carrefinho/caroline/ergogen/README.md

# Ergogen config

[`config.yaml`](config.yaml) places each key with its own hand-tuned dials under `units`: column splay, pitch and lift, plus per-key nudges and rotations. It outputs outlines (keycaps, plate cutouts, keywell, case cutout) that serve as references for the KiCad PCB file and the case.
