carrefinho/caroline/caroline-pcb/caroline-pcb.step

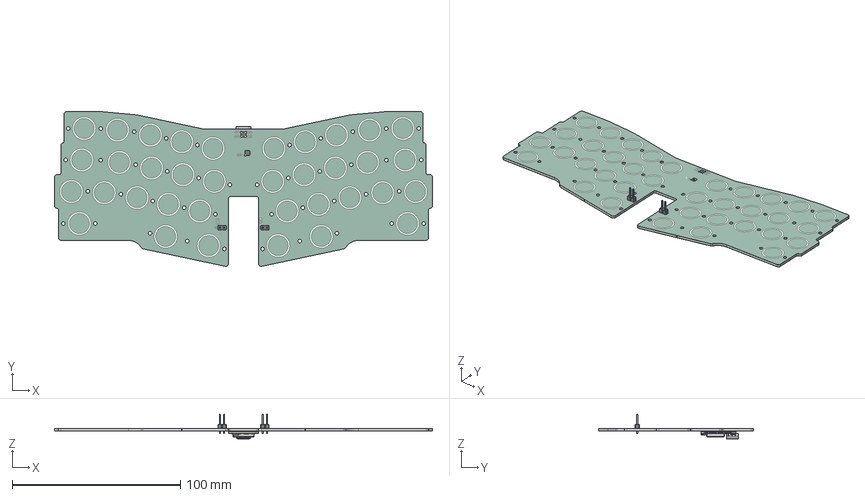
[picture p2: CAD file, 2026-11-11]
caroline-pcb/caroline-pcb.step
224.9 x 92.1 x 14.6 mm
PinHeader_1x02_P254mm_Vertical x 2
BOSS-EXTRUDE14_8_
BOSS-EXTRUDE7_4_
BOSS-EXTRUDE7_3_
BOSS-EXTRUDE14_4_
BOSS-EXTRUDE14_2_
BOSS-EXTRUDE14_11_
BOSS-EXTRUDE7_7_
BOSS-EXTRUDE14_9_
BOSS-EXTRUDE14_3_
BOSS-EXTRUDE14_7_
MIRROR2
BOSS-EXTRUDE14_5_
BOSS-EXTRUDE14_12_
BOSS-EXTRUDE7_8_
BOSS-EXTRUDE7_1_
BOSS-EXTRUDE14_10_
BOSS-EXTRUDE7_9_
BOSS-EXTRUDE14_6_
BOSS-EXTRUDE14_1_
BOSS-EXTRUDE7_6_
BOSS-EXTRUDE7_2_
CUT-EXTRUDE5
BOSS-EXTRUDE7_5_
Shield
Pins
CAP x 2
ANT1
Silkscreen
CAP 3
LED
USR
2 v1
055A-pcb_silkscreen x 2
055A-pcb_soldermask x 2
055A-pcb_PCB
