carrefinho/caroline/caroline-pcb/caroline-pcb.kicad_pcb

## KiCad design caroline-pcb/caroline-pcb.kicad_pcb (2026-11-12)

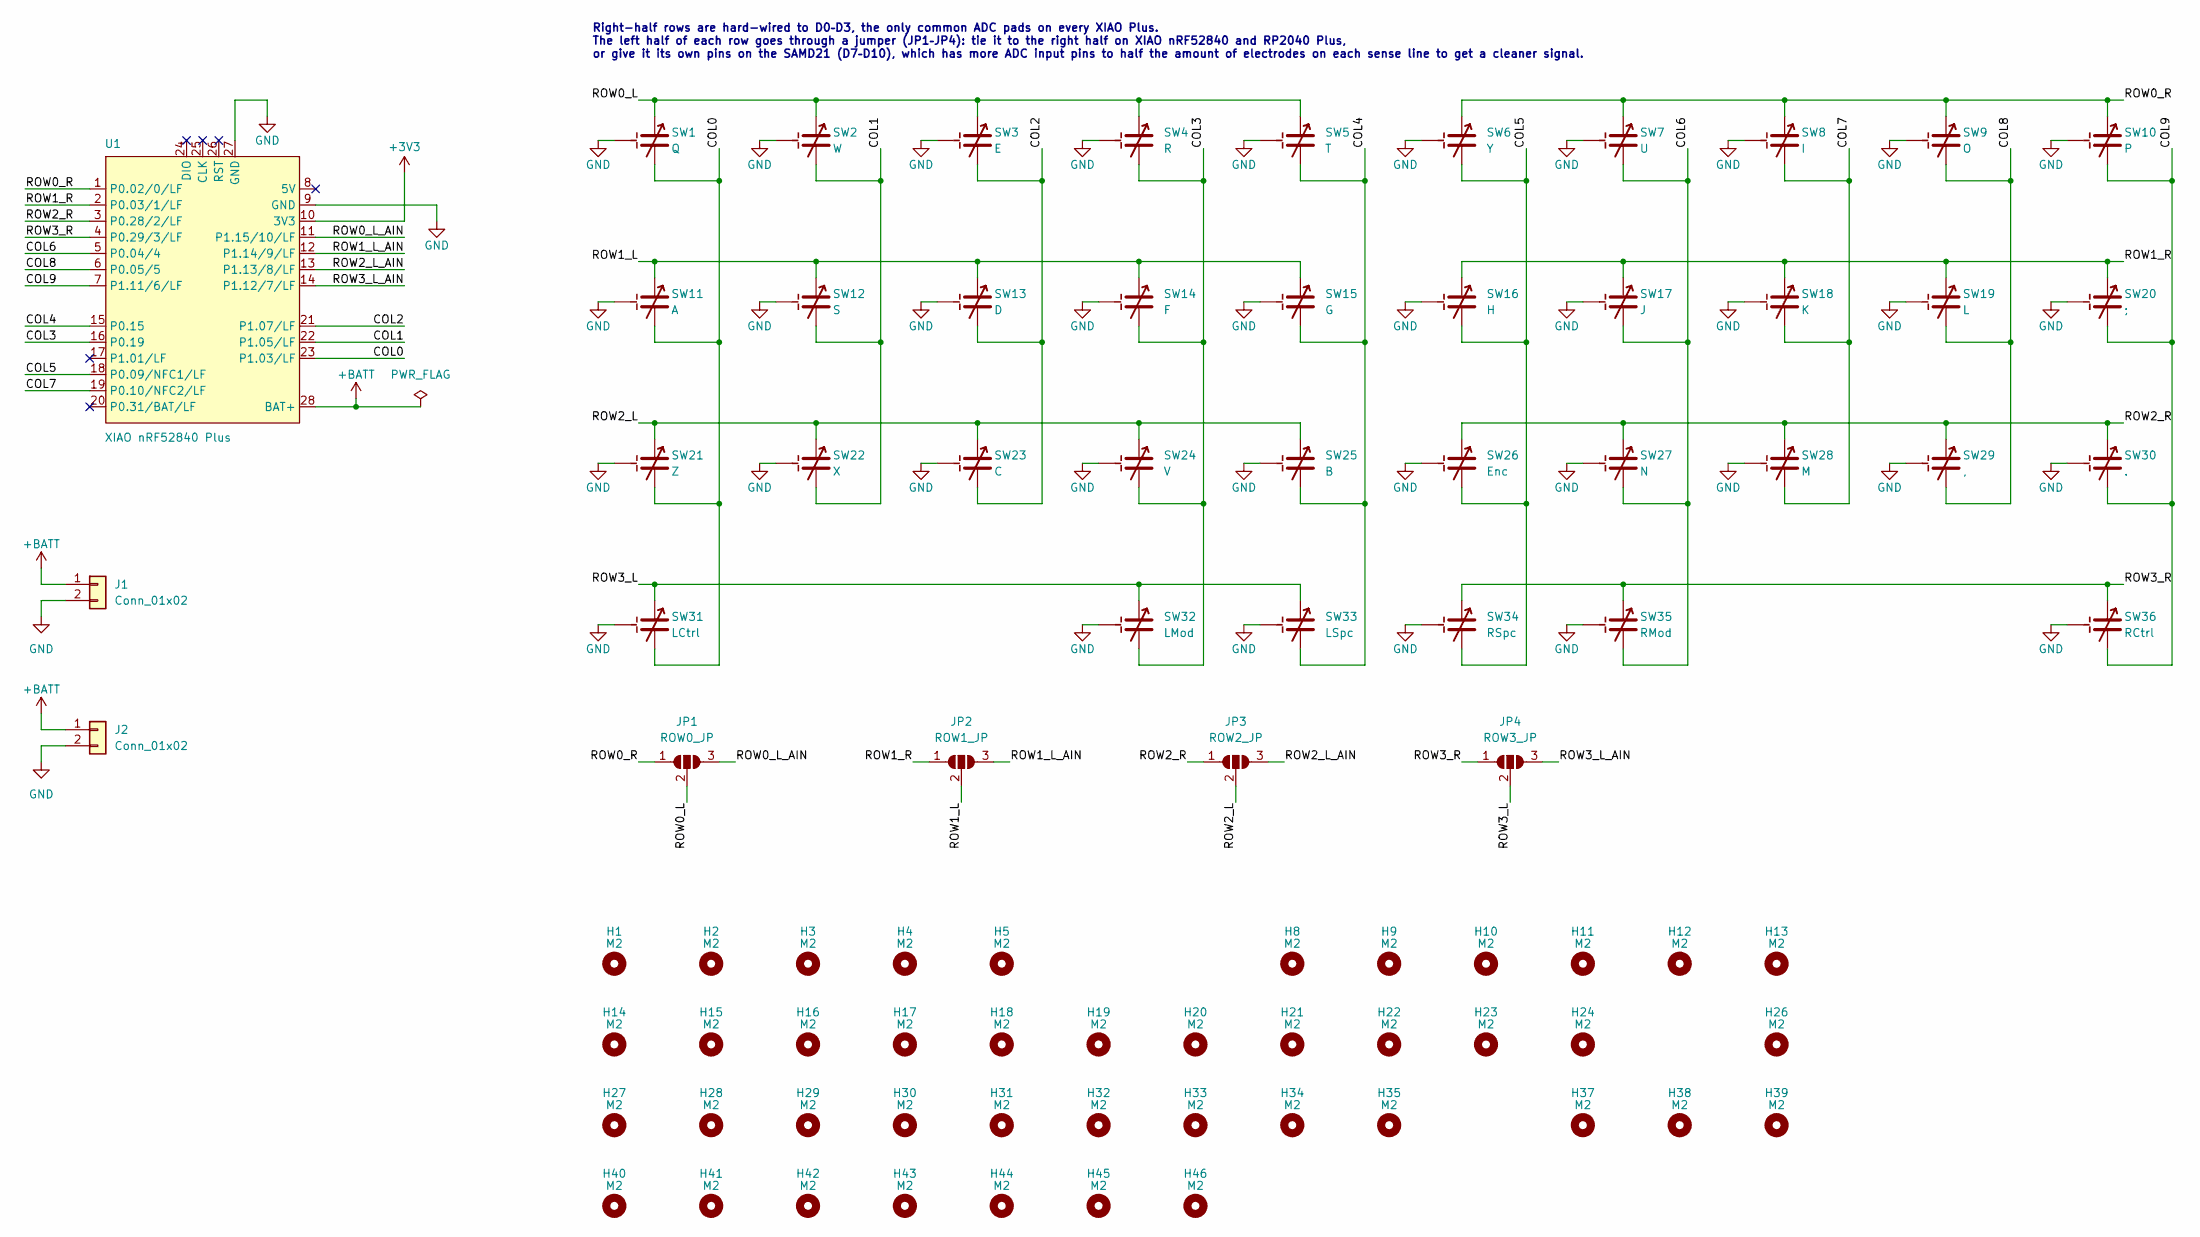
[picture p3: schematic caroline-pcb.kicad_sch]

Parts:
H1, H3, H5, H8, H10, H12, H15, H17, H20, H22, H26, H28, H33, H35, H37, H39, H41, H42, H44, H46: M2; MountingHole_2.2mm_M2_ring_silk
H2, H4, H9, H11, H13, H14, H16, H18, H19, H21, H23, H24, H27, H29, H30, H31, H32, H34, H38, H40, H43, H45: M2; MountingHole_2.2mm_M2
J1, J2: Conn_01x02; PinHeader_1x02_P2.54mm_Vertical
JP1: ROW0_JP; SolderJumper-3_P1.3mm_Open_RoundedPad1.0x1.5mm
JP2: ROW1_JP; SolderJumper-3_P1.3mm_Open_RoundedPad1.0x1.5mm
JP3: ROW2_JP; SolderJumper-3_P1.3mm_Open_RoundedPad1.0x1.5mm
JP4: ROW3_JP; SolderJumper-3_P1.3mm_Open_RoundedPad1.0x1.5mm
SW1: Q; EC_Topre_1U_ViaSP
SW2: W; EC_Topre_1U_ViaSP
SW3: E; EC_Topre_1U_ViaSP
SW4: R; EC_Topre_1U_ViaSP
SW5: T; EC_Topre_1U_ViaSP
SW6: Y; EC_Topre_1U_ViaSP
SW7: U; EC_Topre_1U_ViaSP
SW8: I; EC_Topre_1U_ViaSP
SW9: O; EC_Topre_1U_ViaSP
SW10: P; EC_Topre_1U_ViaSP
SW11: A; EC_Topre_1U_ViaSP
SW12: S; EC_Topre_1U_ViaSP
SW13: D; EC_Topre_1U_ViaSP
SW14: F; EC_Topre_1U_ViaSP
SW15: G; EC_Topre_1U_ViaSP
SW16: H; EC_Topre_1U_ViaSP
SW17: J; EC_Topre_1U_ViaSP
SW18: K; EC_Topre_1U_ViaSP
SW19: L; EC_Topre_1U_ViaSP
SW20: ;; EC_Topre_1U_ViaSP
SW21: Z; EC_Topre_1U_ViaSP
SW22: X; EC_Topre_1U_ViaSP
SW23: C; EC_Topre_1U_ViaSP
SW24: V; EC_Topre_1U_ViaSP
SW25: B; EC_Topre_1U_ViaSP
SW26: Enc; EC_Topre_1U_ViaSP
SW27: N; EC_Topre_1U_ViaSP
SW28: M; EC_Topre_1U_ViaSP
SW29: ,; EC_Topre_1U_ViaSP
SW30: .; EC_Topre_1U_ViaSP
SW31: LCtrl; EC_Topre_1U_ViaSP
SW32: LMod; EC_Topre_1U_ViaSP
SW33: LSpc; EC_Topre_1U_ViaSP
SW34: RSpc; EC_Topre_1U_ViaSP
SW35: RMod; EC_Topre_1U_ViaSP
SW36: RCtrl; EC_Topre_1U_ViaSP
U1: XIAO nRF52840 Plus; Xiao_nRF52840_Plus

Connections:
+3V3: U1.10 (3V3)
+BATT: J1.1, J2.1, U1.28 (BAT+)
/COL0: SW1.2, SW11.2, SW21.2, SW31.2, U1.23 (P1.03/LF)
/COL1: SW2.2, SW12.2, SW22.2, U1.22 (P1.05/LF)
/COL2: SW3.2, SW13.2, SW23.2, U1.21 (P1.07/LF)
/COL3: SW4.2, SW14.2, SW24.2, SW32.2, U1.16 (P0.19)
/COL4: SW5.2, SW15.2, SW25.2, SW33.2, U1.15 (P0.15)
/COL5: SW6.2, SW16.2, SW26.2, SW34.2, U1.18 (P0.09/NFC1/LF)
/COL6: SW7.2, SW17.2, SW27.2, SW35.2, U1.5 (P0.04/4)
/COL7: SW8.2, SW18.2, SW28.2, U1.19 (P0.10/NFC2/LF)
/COL8: SW9.2, SW19.2, SW29.2, U1.6 (P0.05/5)
/COL9: SW10.2, SW20.2, SW30.2, SW36.2, U1.7 (P1.11/6/LF)
/ROW0_L: JP1.2 (C), SW1.1 (S), SW2.1 (S), SW3.1 (S), SW4.1 (S), SW5.1 (S)
/ROW0_L_AIN: JP1.3 (B), U1.11 (P1.15/10/LF)
/ROW0_R: JP1.1 (A), SW6.1 (S), SW7.1 (S), SW8.1 (S), SW9.1 (S), SW10.1 (S), U1.1 (P0.02/0/LF)
/ROW1_L: JP2.2 (C), SW11.1 (S), SW12.1 (S), SW13.1 (S), SW14.1 (S), SW15.1 (S)
/ROW1_L_AIN: JP2.3 (B), U1.12 (P1.14/9/LF)
/ROW1_R: JP2.1 (A), SW16.1 (S), SW17.1 (S), SW18.1 (S), SW19.1 (S), SW20.1 (S), U1.2 (P0.03/1/LF)
/ROW2_L: JP3.2 (C), SW21.1 (S), SW22.1 (S), SW23.1 (S), SW24.1 (S), SW25.1 (S)
/ROW2_L_AIN: JP3.3 (B), U1.13 (P1.13/8/LF)
/ROW2_R: JP3.1 (A), SW26.1 (S), SW27.1 (S), SW28.1 (S), SW29.1 (S), SW30.1 (S), U1.3 (P0.28/2/LF)
/ROW3_L: JP4.2 (C), SW31.1 (S), SW32.1 (S), SW33.1 (S)
/ROW3_L_AIN: JP4.3 (B), U1.14 (P1.12/7/LF)
/ROW3_R: JP4.1 (A), SW34.1 (S), SW35.1 (S), SW36.1 (S), U1.4 (P0.29/3/LF)
GND: J1.2, J2.2, SW1.3 (D), SW2.3 (D), SW3.3 (D), SW4.3 (D), SW5.3 (D), SW6.3 (D), SW7.3 (D), SW8.3 (D), SW9.3 (D), SW10.3 (D), SW11.3 (D), SW12.3 (D), SW13.3 (D), SW14.3 (D), SW15.3 (D), SW16.3 (D), SW17.3 (D), SW18.3 (D), SW19.3 (D), SW20.3 (D), SW21.3 (D), SW22.3 (D), SW23.3 (D), SW24.3 (D), SW25.3 (D), SW26.3 (D), SW27.3 (D), SW28.3 (D), SW29.3 (D), SW30.3 (D), SW31.3 (D), SW32.3 (D), SW33.3 (D), SW34.3 (D), SW35.3 (D), SW36.3 (D), U1.9 (GND), U1.27 (GND)

Notes on the sheet:
Right-half rows are hard-wired to D0–D3, the only common ADC pads on every XIAO Plus. The left half of each row goes through a jumper (JP1–JP4): tie it to the right half on XIAO nRF52840 and RP2040 Plus, or give it its own pins on the SAMD21 (D7–D10), which has more ADC input pins to half the amoun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

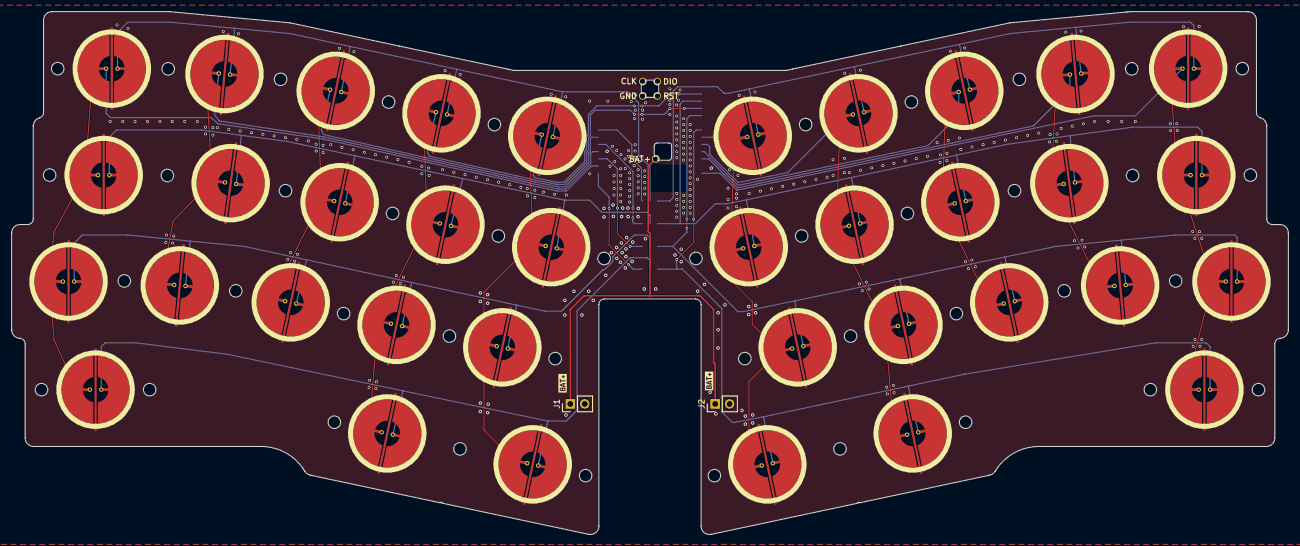
[picture p4: board caroline-pcb.kicad_pcb from above]

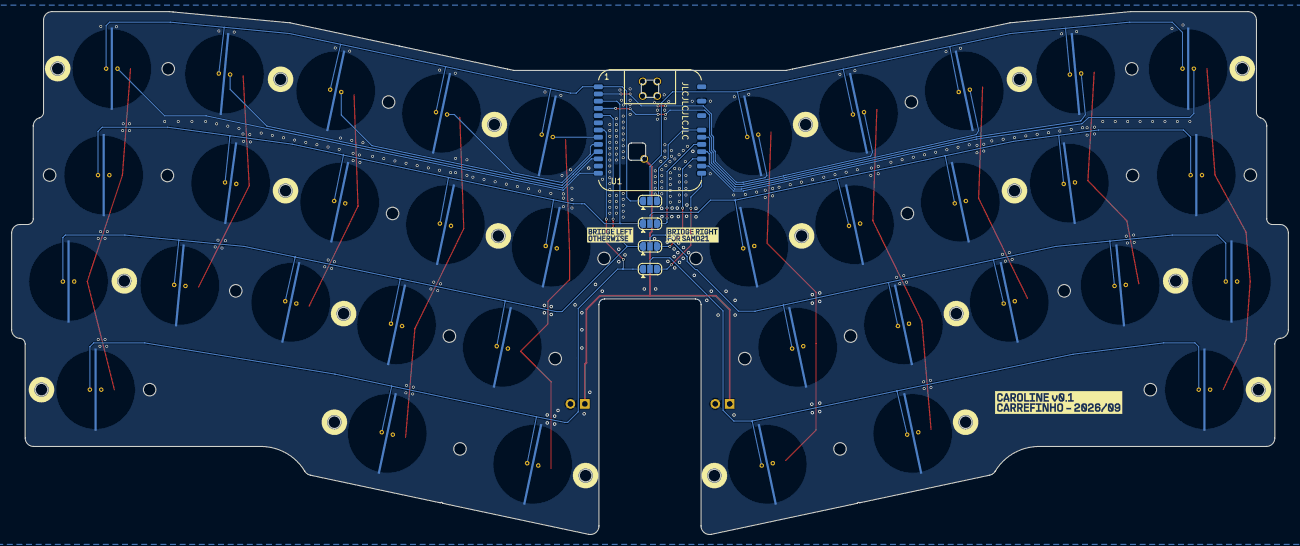
[picture p5: board caroline-pcb.kicad_pcb from below]

Board: 2 copper layers, 224.9 x 92.1 mm, 90 parts (50 on the bottom side), 24 nets.

Other parts of the board:
kibuzzard-6AB9B81E, kibuzzard-6AB9B81E#2: G***; kibuzzard-6AB9B81E
kibuzzard-6AB46F4A: G***; kibuzzard-6AB46F4A
kibuzzard-6AB46F64: G***; kibuzzard-6AB46F64
kibuzzard-6AB51704: G***; kibuzzard-6AB51704
