carrefinho/caroline/(commit log)

2026-11-11 Initial commit: Caroline PCB, CERN-OHL-P v2
    [caroline-pcb.kicad_pcb, caroline-pcb.kicad_sch, caroline-pcb.step]
2026-11-12 kicad: add project library, clean up schematic notes, regen layout.json
    [caroline-pcb.kicad_pcb, caroline-pcb.kicad_sch]
2026-11-12 kicad: mark 20 used screw positions with silk ring
    [caroline-pcb.kicad_pcb, caroline-pcb.kicad_sch]
2026-11-12 tools: add script that picks optimal screw pattern for plate
